antmicro/lpddr4-test-board/lpddr4-test-board.kicad_pcb

## KiCad design lpddr4-test-board.kicad_pcb (2021-01-13)

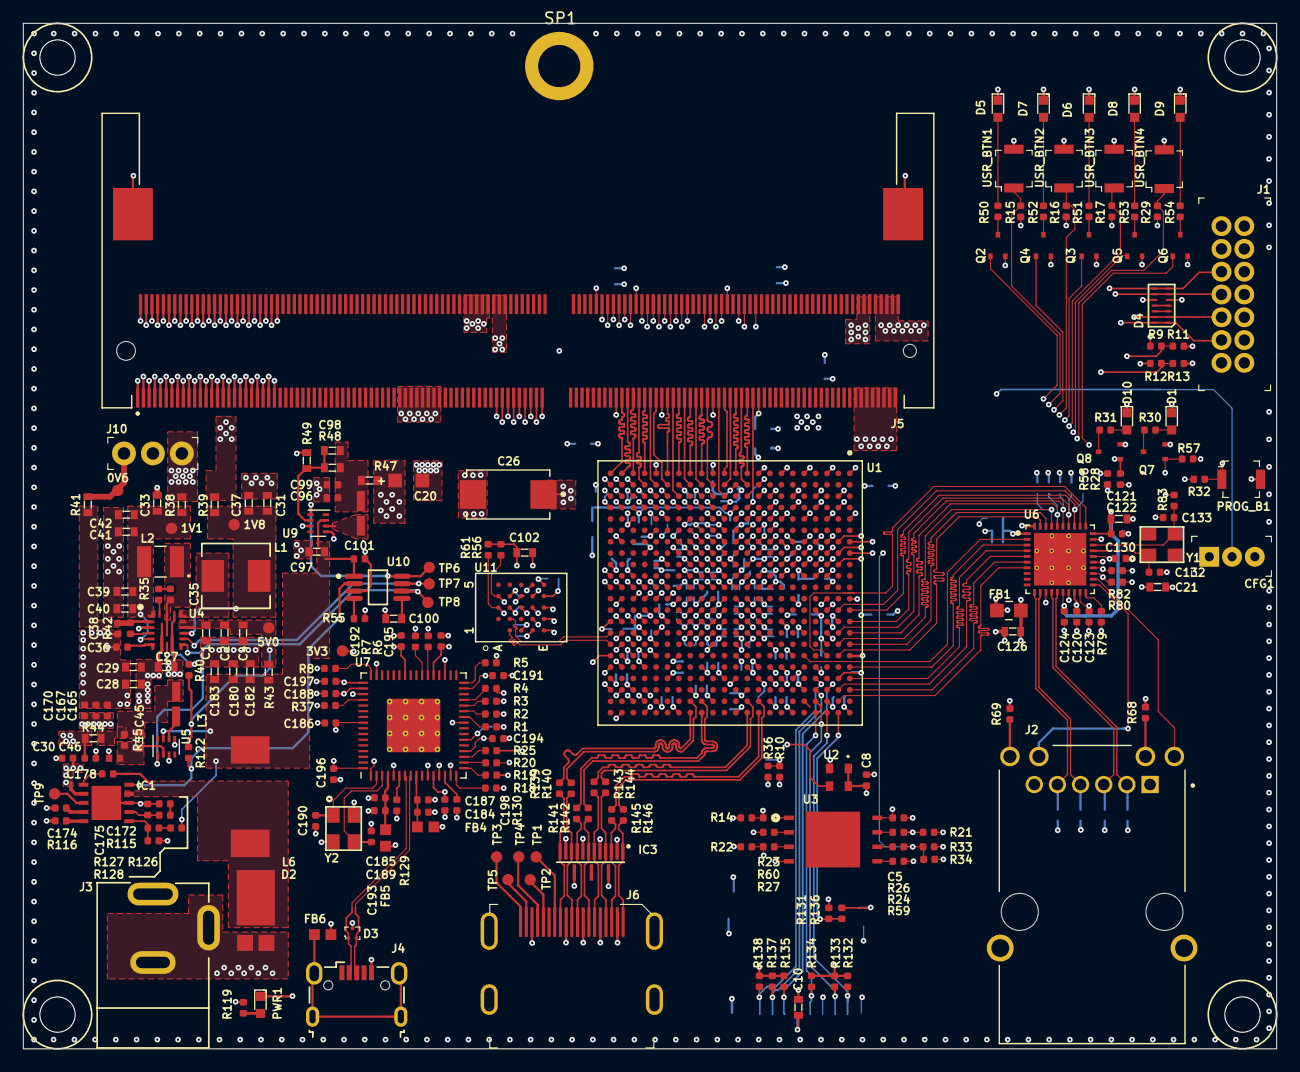
[picture p1: board lpddr4-test-board.kicad_pcb from above]

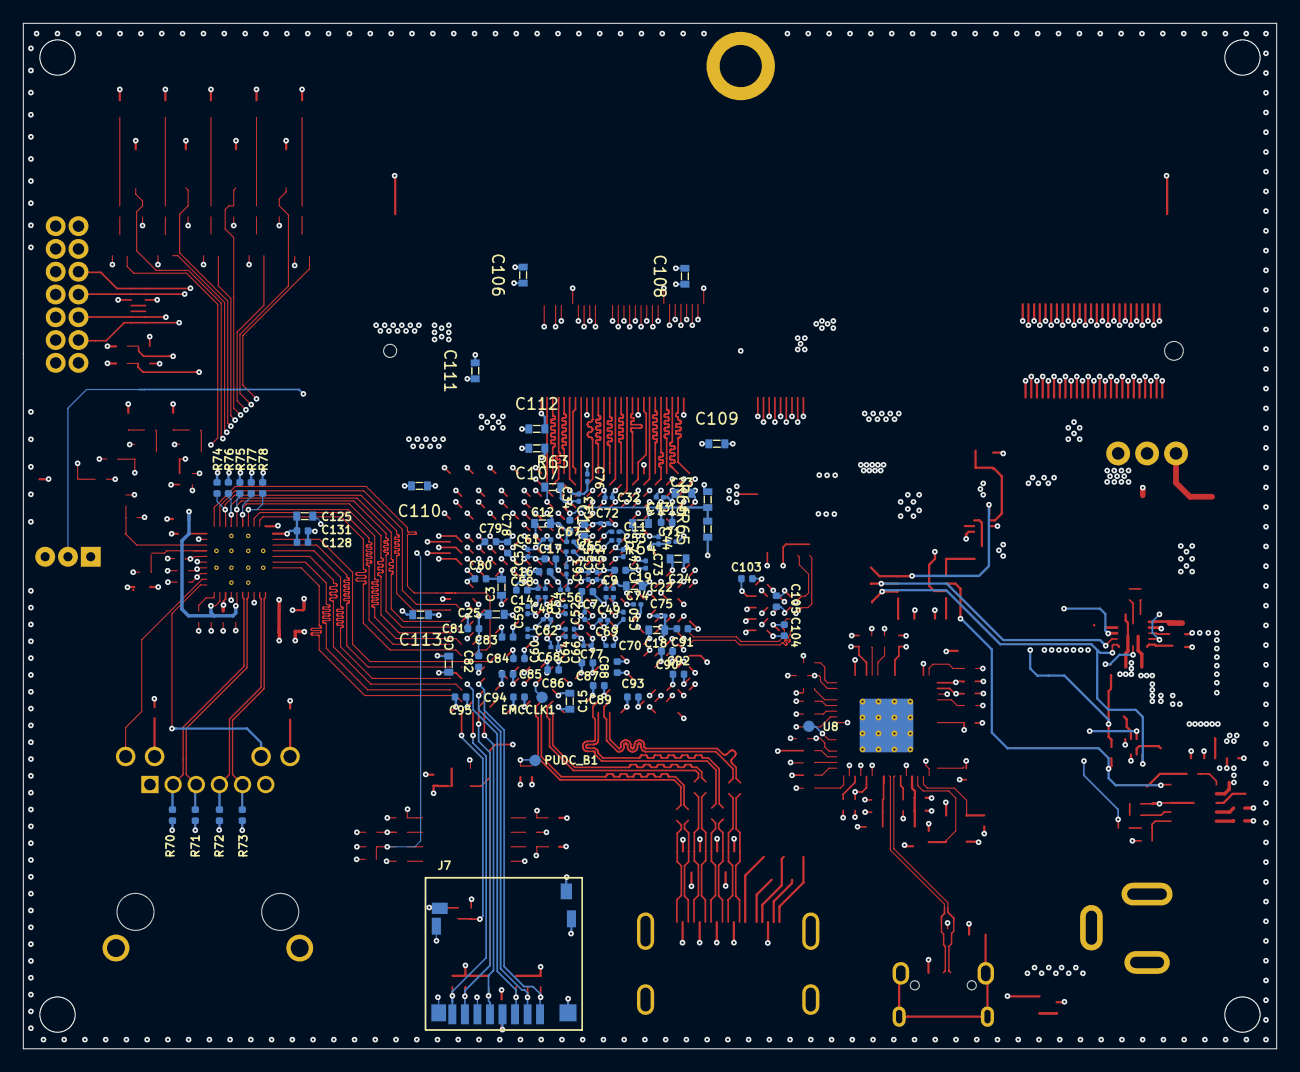
[picture p2: board lpddr4-test-board.kicad_pcb from below]

Board: 8 copper layers, 110.0 x 90.0 mm, 330 parts (103 on the bottom side), 252 nets.

Parts:
0V6, 1V1, 1V8, 3V3, 5V0: TP_SMD1MM; Testpoint_smd_1mm
C1, C33, C121, C125, C126: C_10u_0603; 0603-cap
C2: C_100n_0603; 0603-cap
C3, C6, C12, C15, C18, C21, C22, C23, C24, C25, C102, C180, C182, C183: C_47u_0603; 0603-cap
C4, C10: C_1u_0603; 0603-cap
C5, C8, C35, C101, C103, C104, C105, C114, C115, C120, C122, C123, C124, C130, C131, C178, C184, C185, C186, C188, C191, C192, C194, C196, C197, C198: C_100n_0402_6V3; 0402-cap
C7, C14, C16, C17, C19, C78, C79, C80, C81, C82, C83, C84, C85, C86, C87, C88, C89, C90, C91, C92, C93, C94, C95, C187, C189, C195: C_4u7_0402; 0402-cap
C9, C11, C32, C34, C43, C44, C47, C48, C49, C50, C51, C52, C53, C54, C55, C56, C57, C58, C59, C60, C61, C62, C63, C64, C65, C66, C67, C68, C69, C70, C71, C72, C73, C74, C75, C76, C77: C_100n_0201; 0201-res
C13, C36: C_470n_0402; 0402-cap
C20: C_100u_KEMET_A; KEMET_A
C26: C_330u_KEMET_D; KEMET_D
C27, C28, C29: C_10u_25V_0603; 0603-cap
C30: C_100n_0402_16V; 0402-cap
C31, C37, C39, C40, C41, C42: C_22u_0603; 0603-cap
C38, C46, C96, C99: C_10u_0402; 0402-cap
C45, C98: C_120p_0603; 0603-cap
C97: C_4u7_0603; 0603-cap
C100, C106, C107, C108, C109, C110, C111, C112, C113: C_10n_0603; 0603-cap
C128: C_1u_0402; 0402-cap
C132, C133: C_27p_0402; 0402-cap
C165, C167, C170: C_2u2_0402; 0402-cap
C172: C_4n7_0402; 0402-cap
C174: C_10n_0402; 0402-cap
C175: C_47p_0402; 0402-cap
C190, C193: C_18p_0402; 0402-cap
CFG1: 62000311121
D1, D5, D6, D7, D8, D9, D10: KP-1608CGCK; LED_0603
D2: PDS760-13
D3: TPD2E009; SOT-3
D4: TPD6E05U06
EMCCLK1: test; Testpoint_smd_1mm
FB1: MPZ2012S601AT000; 0805-res
FB4, FB5, FB6: BLM18AG601SN1D; 0603
IC1: TPS54561; WSON-10_4x4
IC3: TPD8S009DSMR; R-PDSO-N15
J1: 0878311420; PinHeader_2x7_P2mm_Drill1mm
J2: 08B0-1X1T-36-F; BEL_08B0-1X1T-36-F
J3: DC_SOCKET
J4: WE_629105150521; USB_Micro_B_Female_629105150521
J5: 2309409-1; TE_2309409-1
J6: 685119134923; HDMI_A_Female_685119134923
J7: 1140084168; MicroSD_1140084168
J10: 61300311121; PinHeader_1x3_P2.54_Drill1.1mm
L1: IHLP2020BZER4R7M01
L2: DFE322512F-R68M=P2; INDC3225X120N
L3, L4: IHLP1212AEERR47M11; IHLP-1212AE
L6: WE_7447798720
PROG_B1: B3U-1000P; Switch_Tactile_SMD_B3U-1000P
PUDC_B1: test; Testpoint_smd_1mm
PWR1: KP-1608CGCK; LED_0603
Q2, Q3, Q4, Q5, Q6, Q7, Q8: BSS138APW; SC70-3
R1, R2, R3, R4, R5, R6, R7, R8, R18, R19, R20, R25, R37: R_22R_0402; 0402-res
R9, R11, R12, R13, R23, R24, R26, R27, R42, R55, R58, R59, R60, R83, R139, R140, R141, R142, R143, R144, R145, R146: R_0R_0402; 0402-res
R10, R33, R34, R36: R_100R_0402; 0402-res
R14, R74, R75, R76, R77, R78: R_2k2_0402; 0402-res
R15, R16, R17, R21, R22, R28, R29, R32: R_4k7_0402; 0402-res
R30, R31, R50, R51, R52, R53, R54, R57, R119: R_330R_0402; 0402-res
R35: R_5R1_0402; 0402-res
R38, R39, R41, R43, R44, R47: R_0R_0603; 0603-res
R40, R122: R_100k_0402; 0402-res
R45: R_453k_0402; 0402-res
R46: R_100k_1%_0402; 0402
R48: R_66k5_0603; 0603-res
R49: R_100k_0603; 0603-res
R56, R61, R80, R130: R_10k_0402; 0402-res
R63, R64: R_120R_0603; 0603-res
R65, R66: R_1k_0603; 0603-res
R68, R69, R136: R_220R_0402; 0402-res
R70, R71, R72, R73, R126: R_49R9_0402; 0402-res
R79: R_4k87_0402; 0402-res
R82: R_1k5_0402; 0402-res
R115: R_16k9_0402; 0402-res
R116: R_243k_0402; 0402-res
R127: R_53k6_0402; 0402-res
R128: R_10k2_0402; 0402-res
R129: R_12k_0402; 0402-res
R131, R132, R133, R134, R135, R137, R138: R_20k_0402; 0402-res
SP1: 9774050151
TP1, TP2, TP3, TP4, TP5, TP6, TP7, TP8, TP9: TP_SMD1MM; Testpoint_smd_1mm
U1: XC7K70T-FBG484; BGA484C100P22X22_2300X2300X244N
U2: ASEM1-100.000MHZ-LC-T; XTAL_ASDM1-25.000MHZ-LC-T
U3: S25FL128SAGNFI000
U4: TPS65296; VQFN-HR
U5, U9: TPS62823DLCT; QFN-8_2x1mm
U6: DP83848JSQ_NOPB; DP83848JSQ-NOPB
U7: FT4232HQ
U8: SRST; Testpoint_smd_1mm
U10: LM3881MME_NOPB; VSSOP8-Texas_Instruments-DGK0008A
U11: S27KL0641DABHI023; FBGA-24
USR_BTN1, USR_BTN2, USR_BTN3, USR_BTN4: B3U-1000P; Switch_Tactile_SMD_B3U-1000P
Y1: ABM8G-25.000MHZ-18-D2Y-T; KX-7
Y2: ABM8G-12.000MHZ-18-D2Y-T; KX-7

Connections:
1V0_SYS: C14.1, C17.1, C20.1, C26.1, C50.1, C52.1, C54.1, C57.1, C58.1, C59.1, C60.1, C61.1, C62.1, C63.1, C64.1, C65.1, C66.1, C67.1, C68.1, C69.1, C70.1, C77.1, R47.1, U1.J9, U1.J11, U1.J13, U1.J15, U1.K8, U1.K14, U1.L9, U1.L13, U1.L15, U1.M8, U1.M14, U1.N9, U1.N13, U1.N15, U1.P14, U1.R13, U1.R15
1V1_SYS: J5.93, J5.95, J5.97, J5.99, J5.101, J5.103, J5.105, J5.107, J5.245, J5.247, J5.249, J5.251, J5.253, J5.255, J5.257, J5.259, J10.1, R38.2
1V8_FT: C195.1, C196.1, C197.1, C198.1, U7.12, U7.37, U7.49, U7.64
1V8_SYS: C7.1, C9.1, C11.1, C16.1, C19.1, C22.1, C25.1, C47.1, C48.1, C49.1, C51.1, C53.1, C55.1, C56.1, C110.1, C111.1, C112.1, C113.1, J5.116, J5.118, J5.120, J5.122, J5.124, J5.252, J5.254, J5.256, J5.258, J5.260, R39.2, U1.K10, U1.K12, U1.M10, U1.P7, U1.P8, U1.P10, U1.P12, U1.R9, U1.R11
3V3_SYS: 3V3.1, C3.1, C5.1, C6.1, C8.1, C10.1, C12.1, C13.1, C15.1, C18.1, C21.1, C46.1, C78.1, C79.1, C80.1, C81.1, C82.1, C83.1, C84.1, C85.1, C86.1, C87.1, C88.1, C89.1, C90.1, C91.1, C92.1, C93.1, C94.1, C95.1, C102.1, C103.1, C104.1, C105.1, C125.1, C128.1, C130.1, C131.1, C186.1, C188.1, C191.1, C192.1, C194.1, CFG1.3, D1.1, D5.1, D6.1, D7.1, D8.1, D9.1, D10.1, FB1.2, FB4.1, FB5.1, IC3.13, IC3.15, J1.2, J7.4, PWR1.1, R9.2, R10.1, R12.2, R14.2, R15.1, R16.1, R17.1, R21.1, R22.1, R28.1, R29.1, R32.1, R33.1, R44.1, R56.1, R57.1, R58.1, R61.1, R74.1, R75.1, R76.1, R80.1, R82.2, R130.1, R131.1, R132.1, R133.1, R134.1, R135.1, R137.1, R138.1, U1.A17, U1.AA17, U1.AB14, U1.B14, U1.C11, U1.C21, U1.D8, U1.D18, U1.E15, U1.F12, U1.F22, U1.G9, U1.G19, U1.H16, U1.J7, U1.K20, U1.L17, U1.N7, U1.N21, U1.P18, U1.T22, U1.U19, U1.V16, U1.Y20, U2.1, U2.4, U3.8, U6.1, U6.26, U7.20, U7.31, U7.42, U7.50, U7.56, U11.B4, U11.D1, U11.E4
/Supply/VCC_AUX_EN: TP7.1, U4.11, U10.7
/Supply/VCC_INT_EN: TP6.1, U9.1, U10.8
/Supply/VCC_IO_EN: TP8.1, U4.10, U5.1, U10.6
AUX_JTAG_RST: R5.2, U1.AB17
AUX_JTAG_TCK: R1.2, U1.W22
AUX_JTAG_TDI: R2.2, U1.W20
AUX_JTAG_TDO: R3.2, U1.W21
AUX_JTAG_TMS: R4.2, U1.Y21
CA2_A: J5.162, U1.AA4
CA3_A: J5.160, U1.AA3
CA4_A: J5.158, U1.AB3
CA5_A: J5.156, U1.AB2
CA_0A: J5.204, U1.L3
CA_1A: J5.206, U1.L5
CCLK: R24.2, R33.2, R34.1, U1.G7
CFGBVS: R58.2, U1.M7
CKE0_A: J5.196, U1.N4
CK_CA: J5.164, U1.Y2
CK_TA: J5.166, U1.Y3
CS0_A: J5.194, U1.N3
C_TMDS_CLK_N: IC3.12, J6.12, R139.2
C_TMDS_CLK_P: IC3.10, J6.10, R140.2
C_TMDS_D0_N: IC3.9, J6.9, R141.2
C_TMDS_D0_P: IC3.7, J6.7, R142.2
C_TMDS_D1_N: IC3.6, J6.6, R143.2
C_TMDS_D1_P: IC3.4, J6.4, R144.2
C_TMDS_D2_N: IC3.3, J6.3, R145.2
C_TMDS_D2_P: IC3.1, J6.1, R146.2
DBG_USB_N: D3.1, J4.2, U7.7
DBG_USB_P: D3.2, J4.3, U7.8
DMI_0A: J5.197, U1.M3
DMI_1A: J5.171, U1.W1
DONE: Q7.1, R57.2, U1.P6
DQ00_A: J5.203, U1.L1
DQ01_A: J5.205, U1.K2
DQ02_A: J5.207, U1.K1
DQ03_A: J5.209, U1.K3
DQ04_A: J5.187, U1.R1
DQ05_A: J5.189, U1.P2
DQ06_A: J5.191, U1.P1
DQ07_A: J5.193, U1.N2
DQ08_A: J5.169, U1.W2
DQ09_A: J5.167, U1.Y1
DQ10_A: J5.165, U1.AA1
DQ11_A: J5.163, U1.AB1
DQ12_A: J5.185, U1.R2
DQ13_A: J5.183, U1.T1
DQ14_A: J5.181, U1.T3
DQ15_A: J5.179, U1.U1
DQ_S0_CA: J5.199, U1.M1
DQ_S0_TA: J5.201, U1.M2
DQ_S1_CA: J5.173, U1.V2
DQ_S1_TA: J5.175, U1.U2
EMCCLK: EMCCLK1.1, U1.J19
ETH3V3: C120.1, C126.1, FB1.1, J2.1, J2.6, R68.2, R69.2, R70.1, R71.1, R72.1, R73.1, U6.18
ETH_COL: R75.2, U1.B15, U6.35
ETH_CRS: R74.2, U1.A13, U6.33
ETH_MDC: U1.C14, U6.25
ETH_MDIO: R82.1, U1.C13, U6.24
ETH_REF_CLK: R83.2, U1.C12
ETH_RSTN: R80.2, U1.C15, U6.23
ETH_RXD0: R77.2, U1.A15, U6.36
ETH_RXD1: R78.2, U1.B16, U6.37
ETH_RXD2: U1.A16, U6.38
ETH_RXD3: U1.B17, U6.39
ETH_RXERR: R76.2, U1.A14, U6.34
ETH_RX_CLK: U1.C17, U6.31
ETH_RX_DV: U1.B13, U6.32
ETH_TXD0: U1.A19, U6.4
ETH_TXD1: U1.B20, U6.5
ETH_TXD2: U1.A20, U6.6
ETH_TXD3: U1.B21, U6.7
ETH_TX_CLK: U1.E17, U6.2
ETH_TX_EN: U1.A18, U6.3
FCS_B: R14.1, R23.2, U1.L16
GCLK100: U1.L19, U2.3
GND: C1.2, C2.2, C3.2, C4.2, C5.2, C6.2, C7.2, C8.2, C9.2, C10.2, C11.2, C12.2, C13.2, C14.2, C15.2, C16.2, C17.2, C18.2, C19.2, C20.2, C21.2, C22.2, C23.2, C24.2, C25.2, C26.2, C27.2, C28.2, C29.2, C30.2, C31.2, C32.2, C33.2, C34.2, C36.2, C37.2, C38.2, C39.2, C40.2, C41.2, C42.2, C43.2, C44.2, C46.2, C47.2, C48.2, C49.2, C50.2, C51.2, C52.2, C53.2, C54.2, C55.2, C56.2, C57.2, C58.2, C59.2, C60.2, C61.2, C62.2, C63.2, C64.2, C65.2, C66.2, C67.2, C68.2, C69.2, C70.2, C71.2, C72.2, C73.2, C74.2, C75.2, C76.2, C77.2, C78.2, C79.2, C80.2, C81.2, C82.2, C83.2, C84.2, C85.2, C86.2, C87.2, C88.2, C89.2, C90.2, C91.2, C92.2, C93.2, C94.2, C95.2, C96.2, C97.2, C99.2, C100.1, C101.2, C102.2, C103.2, C104.2, C105.2, C106.2, C107.2, C108.2, C109.2, C110.2, C111.2, C112.2, C113.2, C114.2, C115.2, C120.2, C121.2, C122.2, C123.2, C124.2, C125.2, C126.2, C128.2, C130.2, C131.2, C132.2, C133.2, C165.2, C167.2, C170.2, C172.2, C174.2, C175.2, C180.2, C182.2, C183.2, C184.2, C185.2, C186.2, C187.2, C188.2, C189.2, C190.2, C191.2, C192.2, C193.2, C194.2, C195.2, C196.2, C197.2, C198.2, CFG1.1, D2.A, D3.3, D4.5, D4.10, FB6.1, IC1.8, IC1.11, IC3.2, IC3.5, IC3.8, IC3.11, J1.1, J1.3, J1.5, J1.7, J1.9, J1.11, J1.13, J2.SH, J3.2, J3.3, J4.5, J5.1, J5.2, J5.3, J5.4, J5.5, J5.6, J5.7, J5.8, J5.9, J5.10, J5.11, J5.12, J5.13, J5.14, J5.15, J5.16, J5.17, J5.18, J5.19, J5.20, J5.21, J5.22, J5.23, J5.24, J5.25, J5.26, J5.27, J5.28, J5.29, J5.30, J5.31, J5.32, J5.33, J5.34, J5.35, J5.36, J5.37, J5.38, J5.39, J5.40, J5.41, J5.42, J5.43, J5.44, J5.45, J5.46, J5.47, J5.48, J5.49, J5.50, J5.154, J5.161, J5.168, J5.177, J5.184, J5.195, J5.200, J5.210, J5.211, J5.S1, J5.S2, J6.2, J6.5, J6.8, J6.11, J6.17, J6.SH, J7.6, J7.10, J7.~, PROG_B1.2, Q2.2, Q3.2, Q4.2, Q5.2, Q6.2, Q7.2, Q8.2, R11.2, R13.2, R34.2, R36.2, R46.2, R49.2, R55.2, R64.2, R66.2, R77.1, R78.1, R79.1, R116.1, R119.2, R128.2, R129.1, U1.A1, U1.A5, U1.A7, U1.A12, U1.A22, U1.AA2, U1.AA12, U1.AA22, U1.AB9, U1.AB19, U1.B3, U1.B4, U1.B7, U1.B9, U1.B19, U1.C1, U1.C5, U1.C7, U1.C16, U1.D3, U1.D4, U1.D7, U1.D13, U1.E1, U1.E5, U1.E7, U1.E10, U1.E20, U1.F3, U1.F4, U1.F7, U1.F17, U1.G1, U1.G5, U1.G14, U1.H3, U1.H4, U1.H5, U1.H11, U1.H21, U1.J1, U1.J2, U1.J3, U1.J8, U1.J10, U1.J12, U1.J14, U1.J18, U1.K5, U1.K9, U1.K11, U1.K13, U1.K15, U1.L2, U1.L8, U1.L10, U1.L11, U1.L12, U1.L14, U1.L22, U1.M9, U1.M11, U1.M12, U1.M13, U1.M15, U1.M19, U1.N6, U1.N8, U1.N10, U1.N11, U1.N12, U1.N14, U1.N16, U1.P3, U1.P9, U1.P11, U1.P13, U1.P15, U1.R8, U1.R10, U1.R12, U1.R14, U1.R20, U1.T7, U1.T17, U1.U4, U1.U14, U1.V1, U1.V11, U1.V21, U1.W8, U1.W18, U1.Y5, U1.Y15, U2.2, U3.4, U4.3, U4.9, U4.16, U5.3, U5.5, U6.13, U6.17, U6.29, U6.40, U7.1, U7.5, U7.11, U7.13, U7.15, U7.25, U7.35, U7.47, U7.51, U7.65, U9.3, U9.5, U10.3, U11.B3, U11.C1, U11.E5, USR_BTN1.2, USR_BTN2.2, USR_BTN3.2, USR_BTN4.2, Y2.2, Y2.4
HR_CKN: U1.AB16, U11.B1
HR_CKP: U1.AB15, U11.B2
HR_CS: R61.2, U1.AA16, U11.A3
HR_DQ0: U1.W15, U11.D3
HR_DQ1: U1.AA15, U11.D2
HR_DQ2: U1.AA14, U11.C4
HR_DQ3: U1.W14, U11.D4
HR_DQ4: U1.Y14, U11.D5
HR_DQ5: U1.V15, U11.E3
HR_DQ6: U1.Y16, U11.E2
HR_DQ7: U1.W17, U11.E1
HR_RST: R56.2, U1.V17, U11.A4
HR_RW: U1.Y17, U11.C3
INIT_B: Q8.1, R28.2, U1.L7
IO_AA11: J5.139, U1.AA11
IO_AB10: J5.143, U1.AB10
IO_AB11: J5.141, U1.AB11
IO_M5: J5.198, U1.M5
IO_N5: J5.192, U1.N5
IO_P4: J5.186, U1.P4
IO_R4: J5.182, U1.R4
IO_T4: J5.180, U1.T4
IO_U3: J5.176, U1.U3
IO_U5: J5.178, U1.U5
IO_U12: J5.127, U1.U12
IO_V3: J5.172, U1.V3
IO_V4: J5.174, U1.V4
IO_V12: J5.129, U1.V12
IO_W4: J5.170, U1.W4
IO_W11: J5.135, U1.W11
IO_W12: J5.131, U1.W12
IO_Y11: J5.137, U1.Y11
IO_Y12: J5.133, U1.Y12
LED_LINK: J2.7, U6.22
LED_SPD: J2.9, U6.21
MODE0: R9.1, R11.1, U1.H7
MODE1: R12.1, R13.1, U1.H6
MODE2: CFG1.2, U1.J5
unnamed: C35.1, L2.1, U4.17
unnamed: C35.2, R35.2
unnamed: C36.1, U4.6
unnamed: C38.1, R41.1, R42.2, U4.2
unnamed: C45.1, L3.2, R44.2, R45.1
unnamed: C45.2, R45.2, R46.1, U5.2
unnamed: C96.1, C98.1, C99.1, L4.2, R47.2, R48.1
unnamed: C98.2, R48.2, R49.1, U9.2
unnamed: C100.2, U10.5
unnamed: C132.1, U6.27, Y1.1
unnamed: C133.1, R83.1, U6.28, Y1.3
unnamed: C172.1, R115.2
unnamed: C174.1, IC1.4
unnamed: C175.1, IC1.7, R115.1
unnamed: C178.1, D2.C, IC1.9, L6.1
unnamed: C178.2, IC1.1
unnamed: C184.1, C187.1, FB4.2, U7.9
unnamed: C185.1, C189.1, FB5.2, U7.4
unnamed: C190.1, U7.2, Y2.1
unnamed: C193.1, U7.3, Y2.3
unnamed: D1.2, R30.1
unnamed: D5.2, R50.1
unnamed: D6.2, R51.1
unnamed: D7.2, R52.1
unnamed: D8.2, R53.1
unnamed: D9.2, R54.1
unnamed: D10.2, R31.1
unnamed: FB6.2, J4.6
unnamed: IC1.3, TP9.1
unnamed: IC1.5, R116.2
unnamed: IC1.6, R127.2, R128.1
unnamed: J2.8, R68.1
unnamed: J2.10, R69.1
unnamed: J6.13, TP1.1
unnamed: J6.15, TP2.1
unnamed: J6.16, TP4.1
unnamed: J6.18, TP5.1
unnamed: J6.19, TP3.1
unnamed: J7.9, R136.2
unnamed: L1.1, U4.15
unnamed: L3.1, U5.6
unnamed: L4.1, U9.6
unnamed: PWR1.2, R119.1
unnamed: Q2.3, R50.2
unnamed: Q3.3, R51.2
unnamed: Q4.3, R52.2
unnamed: Q5.3, R53.2
unnamed: Q6.3, R54.2
unnamed: Q7.3, R30.2
unnamed: Q8.3, R31.2
unnamed: R1.1, U7.26
unnamed: R2.1, U7.27
unnamed: R3.1, U7.28
unnamed: R4.1, U7.29
unnamed: R5.1, U7.32
unnamed: R6.1, U7.38
unnamed: R7.1, U7.39
unnamed: R8.1, U7.48
unnamed: R18.1, U7.16
unnamed: R19.1, U7.17
unnamed: R20.1, U7.18
unnamed: R23.1, U3.1
unnamed: R24.1, U3.6
unnamed: R25.1, U7.19
unnamed: R26.1, U3.7
unnamed: R27.1, U3.3
unnamed: R35.1, U4.18
unnamed: R37.1, U7.52
unnamed: R40.1, U4.8
unnamed: R42.1, U4.4
unnamed: R55.1, U10.4
unnamed: R59.1, U3.5
unnamed: R60.1, U3.2
unnamed: R79.2, U6.20
unnamed: R126.2, R127.1
unnamed: R129.2, U7.6
unnamed: R130.2, U7.14
unnamed: U7.22, U8.1
PFBOUT: C121.1, C122.1, C123.1, C124.1, U6.16, U6.19, U6.30
PROGRAM_B: PROG_B1.1, R32.2, U1.M6
PUDC_B: PUDC_B1.1, R10.2, R36.1, U1.K18
QSPI_DQ0: R59.2, U1.H18
QSPI_DQ1: R60.2, U1.H19
QSPI_DQ2: R22.2, R27.2, U1.G18
QSPI_DQ3: R21.2, R26.2, U1.F19
RXN: J2.5, R73.2, U6.11
RXP: J2.4, R72.2, U6.12
SD_CD: R131.2, R136.1, U1.B22
SD_CLK: J7.5, R134.2, U1.D22
SD_CMD: J7.3, R135.2, U1.C20
SD_DAT0: J7.7, R133.2, U1.D21
SD_DAT1: J7.8, R132.2, U1.C22
SD_DAT2: J7.1, R138.2, U1.D19
SD_DAT3: J7.2, R137.2, U1.D20
SYS_ON: IC1.10, R122.2, U10.2
TCK_JTAG: D4.13, J1.6, R18.2, U1.K7
TDI_JTAG: D4.8, J1.10, R19.2, U1.K6
TDO_JTAG: D4.9, J1.8, R20.2, U1.J6
TMDS_CLK_N: R139.1, U1.R22
TMDS_CLK_P: R140.1, U1.R21
TMDS_D0_N: R141.1, U1.P22
TMDS_D0_P: R142.1, U1.P21
TMDS_D1_N: R143.1, U1.K22
TMDS_D1_P: R144.1, U1.K21
TMDS_D2_N: R145.1, U1.J22
TMDS_D2_P: R146.1, U1.J21
TMS_JTAG: D4.14, J1.4, R25.2, U1.L6
TXN: J2.3, R71.2, U6.14
TXP: J2.2, R70.2, U6.15
UART0_RX: R6.2, U1.AA18
UART0_TX: R7.2, U1.AB18
UART1_RX: R8.2, U1.AB20
UART1_TX: R37.2, U1.AA20
USR_BTN1: R15.2, U1.E8, USR_BTN1.1
USR_BTN2: R16.2, U1.B8, USR_BTN2.1
USR_BTN3: R17.2, U1.C9, USR_BTN3.1
USR_BTN4: R29.2, U1.E9, USR_BTN4.1
USR_LED1: Q2.1, U1.F8
USR_LED2: Q4.1, U1.C8
USR_LED3: Q3.1, U1.A8
USR_LED4: Q5.1, U1.D9
USR_LED5: Q6.1, U1.F9
VCC5V0: 5V0.1, C1.1, C2.1, C4.1, R40.2, R43.1, R122.1, U4.13, U4.14
VCC5V0_INT: C97.1, C101.1, C180.1, C182.1, C183.1, L6.2, R43.2, R126.1, U5.7, U9.7, U10.1
VDD0V6: 0V6.1, J10.3, R41.2
VDD1V1: 1V1.1, C33.1, C39.1, C40.1, C41.1, C42.1, L2.2, R38.1, U4.1, U4.5
VDD1V8: 1V8.1, C31.1, C37.1, L1.2, R39.1, U4.12
VDDQ: C23.1, C24.1, C32.1, C34.1, C43.1, C44.1, C71.1, C72.1, C73.1, C74.1, C75.1, C76.1, C106.1, C107.1, C108.1, C109.1, J5.126, J5.128, J5.130, J5.246, J5.248, J5.250, J10.2, R63.2, R65.1, U1.AA7, U1.AB4, U1.M4, U1.N1, U1.R5, U1.T2, U1.T12, U1.U9, U1.V6, U1.W3, U1.W13, U1.Y10
VIN: C27.1, C28.1, C29.1, C30.1, C165.1, C167.1, C170.1, IC1.2, J3.1, U4.7
VREF_34: C114.1, C115.1, R65.2, R66.1, U1.L4, U1.Y4
VRN: R63.1, U1.K4
VRP: R64.1, U1.V5
